filsuch/NE555/Images/IMG_20250101_210914.jpg

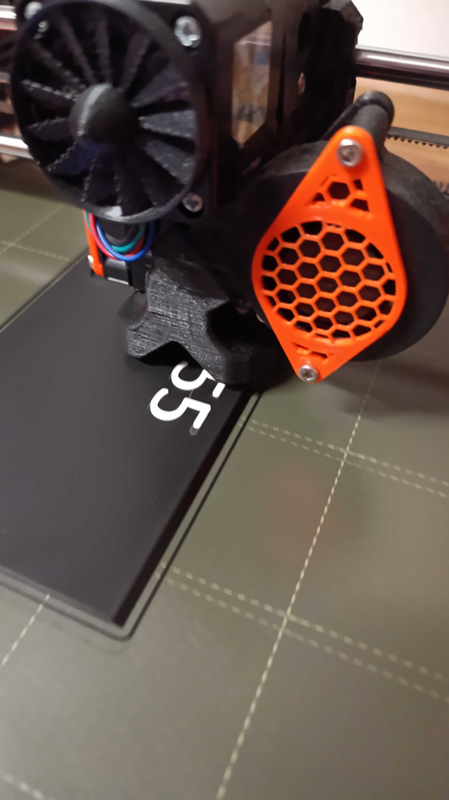
Images/IMG_20250101_210914.jpg
