filsuch/NE555/Images/IMG_20241227_170948.jpg

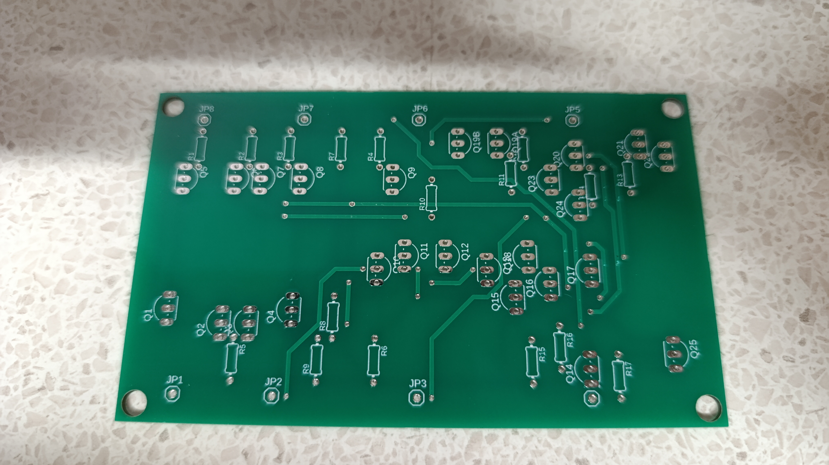
Images/IMG_20241227_170948.jpg
