filsuch/NE555/README.md

# NE555
 školní ročníková práce tvorba NE555
