filsuch/NE555/Images/DPS_bottom.png

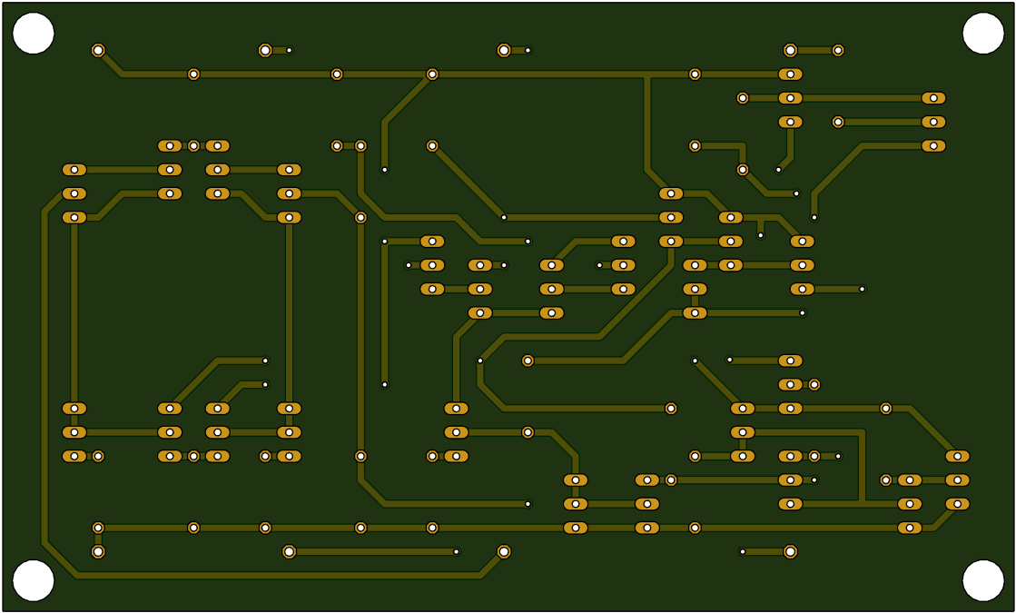
Images/DPS_bottom.png
