filsuch/NE555/Images/DPS_NE555_v2.png

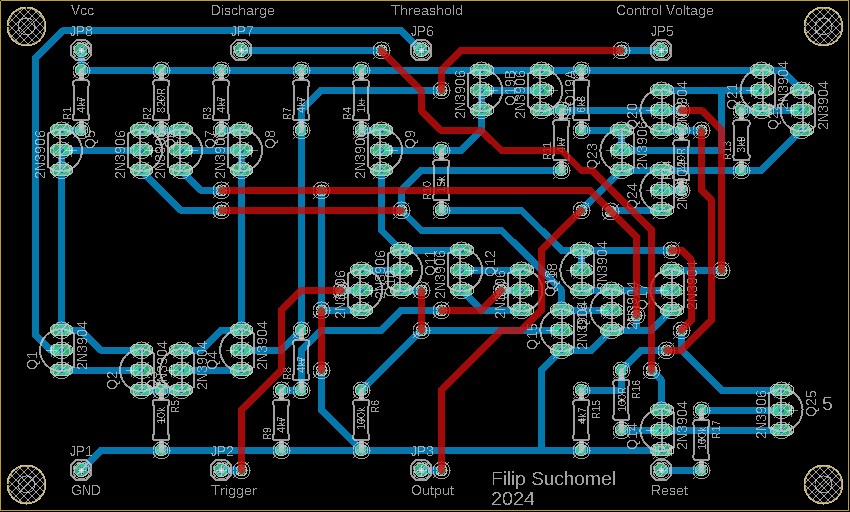
Images/DPS_NE555_v2.png
