filsuch/NE555/Images/Fusion 3d model.png

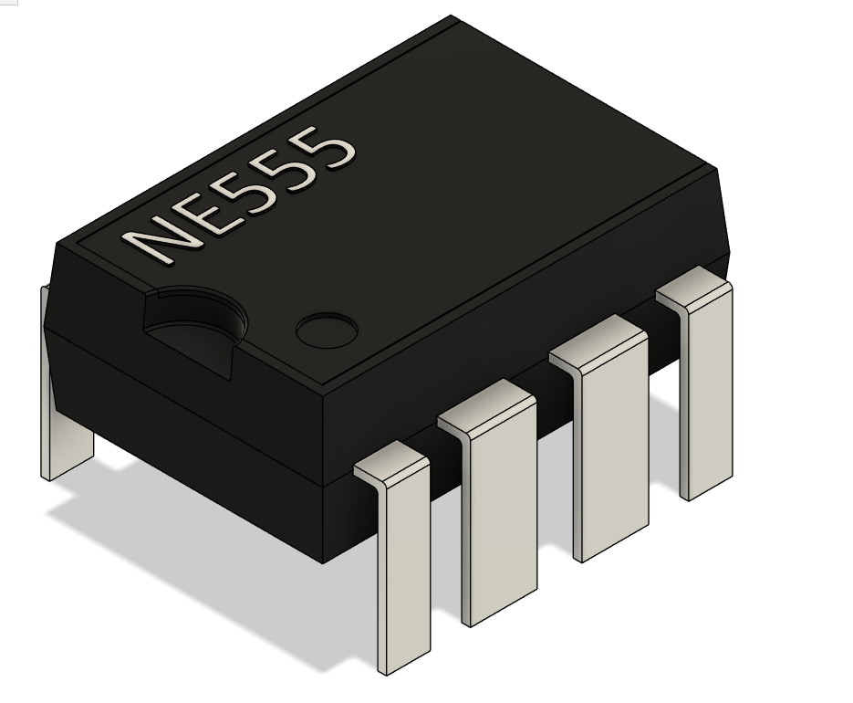
Images/Fusion 3d model.png
