filsuch/NE555/Images/Fusion 3d model_3.png

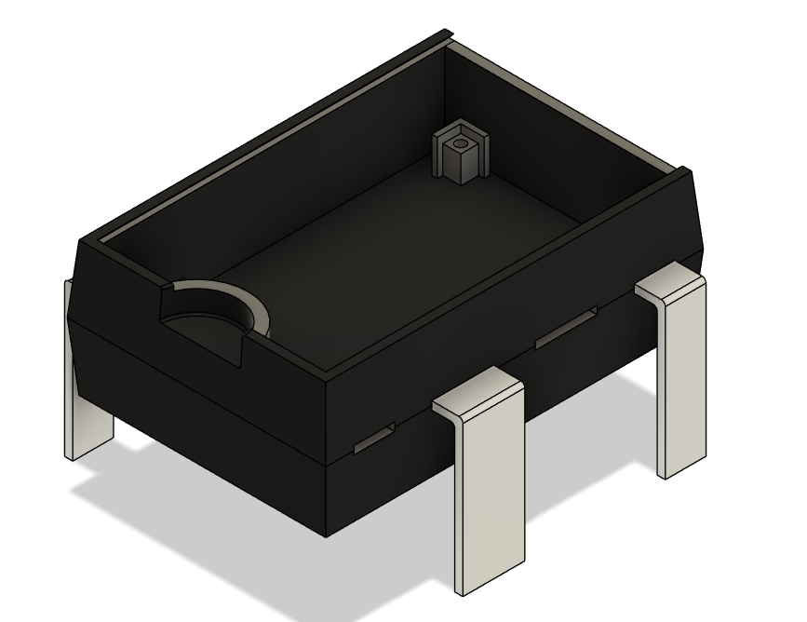
Images/Fusion 3d model_3.png
