filsuch/NE555/Images/IMG_20241227_170939.jpg

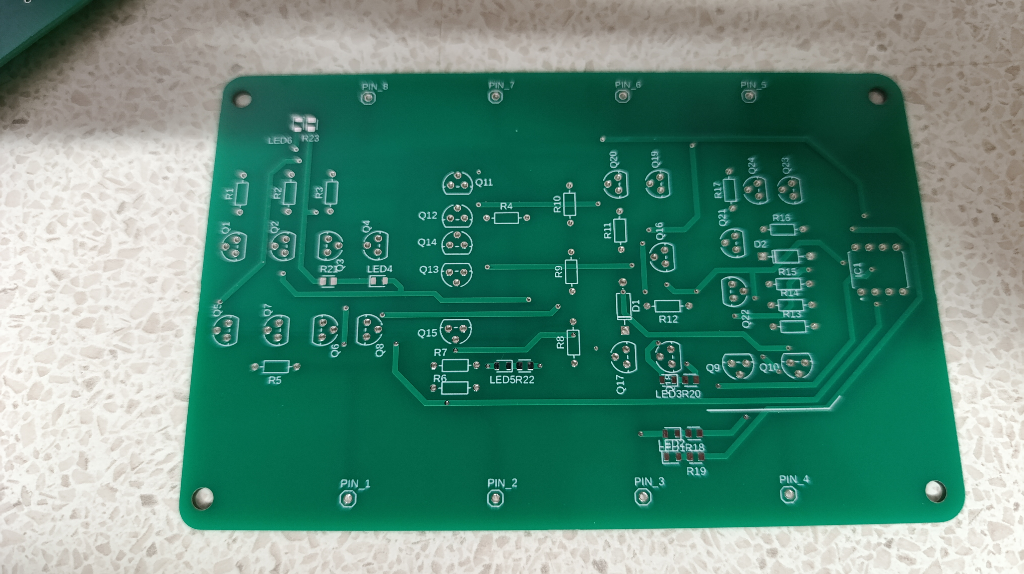
Images/IMG_20241227_170939.jpg
