filsuch/NE555/Images/IMG_20241227_203101.jpg

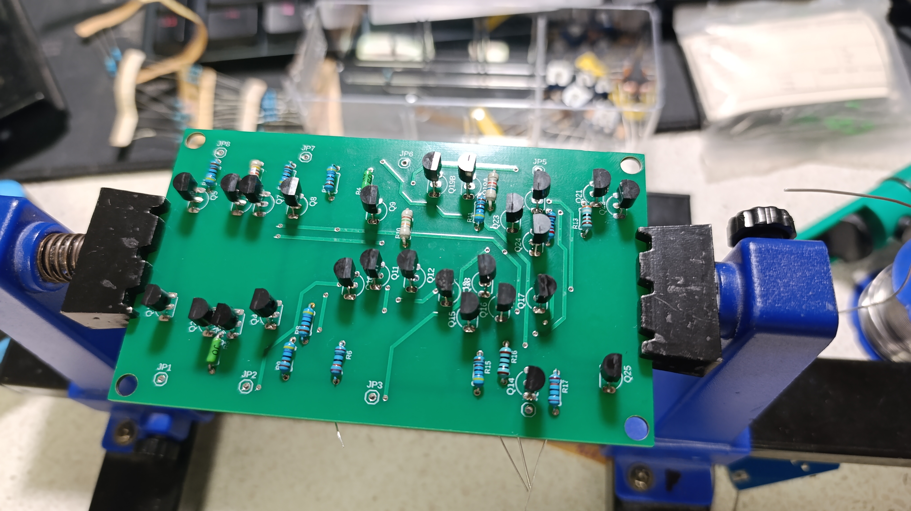
Images/IMG_20241227_203101.jpg
