filsuch/NE555/Images/IMG_20241227_203131.jpg

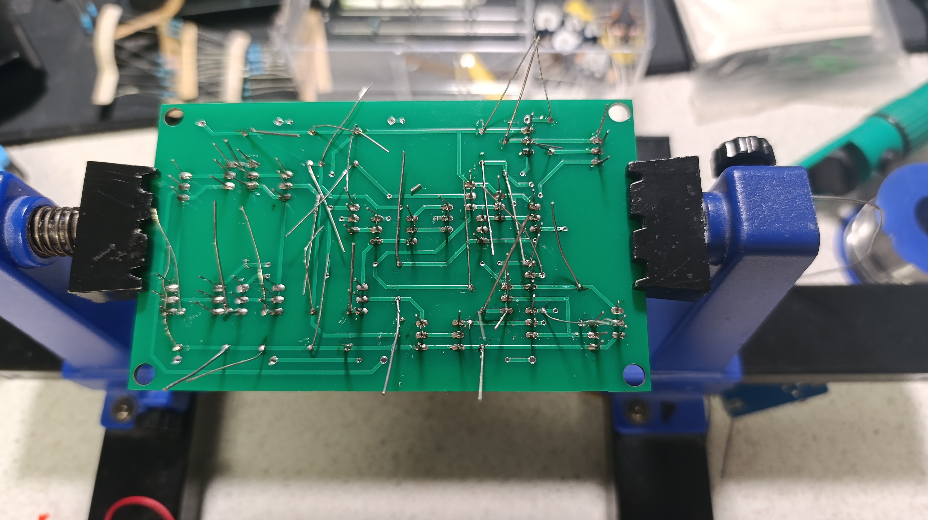
Images/IMG_20241227_203131.jpg
