filsuch/NE555/Images/IMG_20250101_210907.jpg

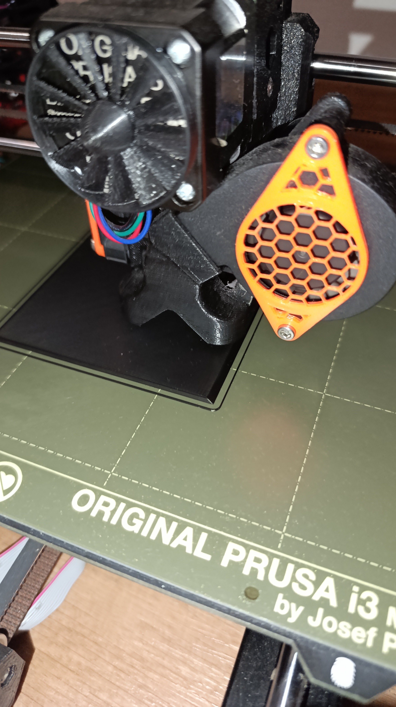
Images/IMG_20250101_210907.jpg
