filsuch/NE555/Images/IMG_20250101_211127.jpg

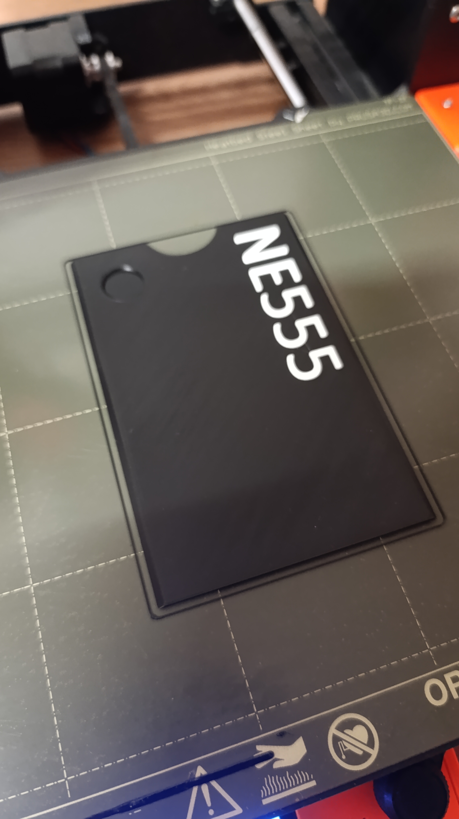
Images/IMG_20250101_211127.jpg
