filsuch/NE555/Images/IMG_20250106_122443.jpg

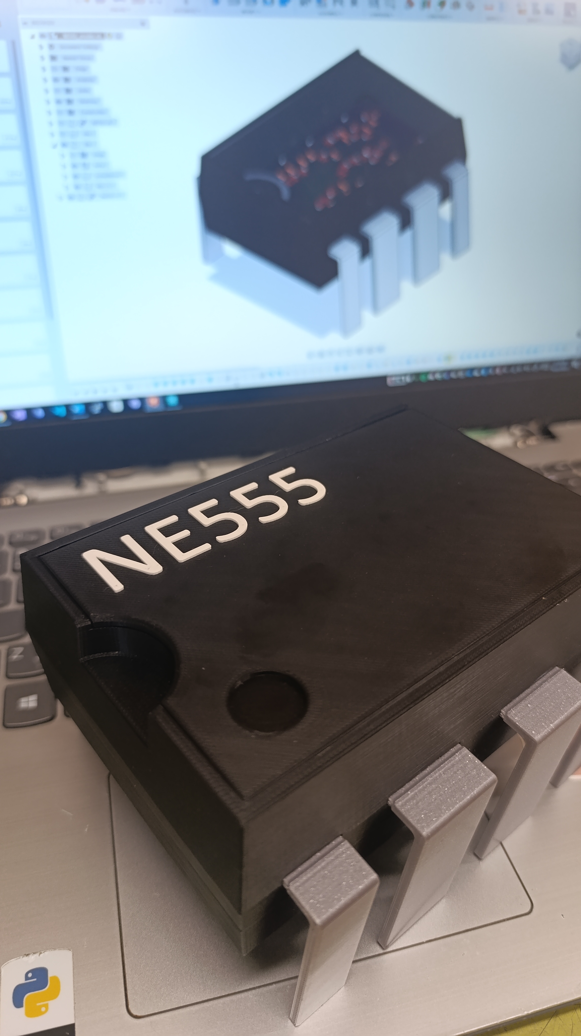
Images/IMG_20250106_122443.jpg
