filsuch/NE555/Images/IMG_20250106_122449.jpg

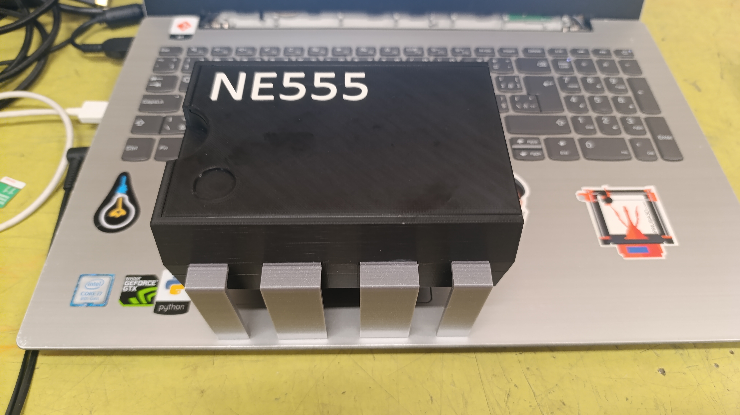
Images/IMG_20250106_122449.jpg
