filsuch/NE555/Images/IMG_20250106_122453.jpg

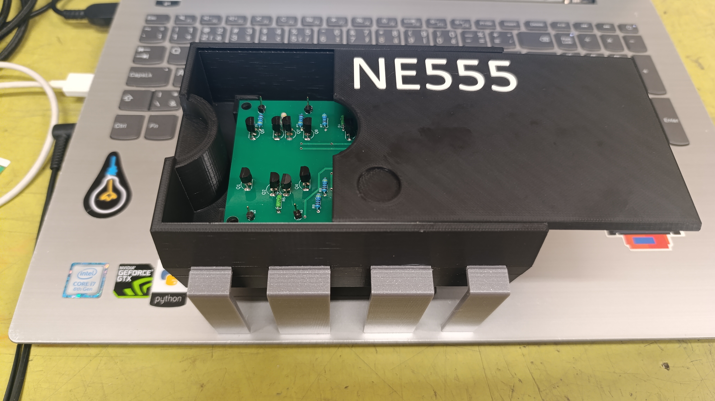
Images/IMG_20250106_122453.jpg
