filsuch/NE555/Images/IMG_20250106_122459.jpg

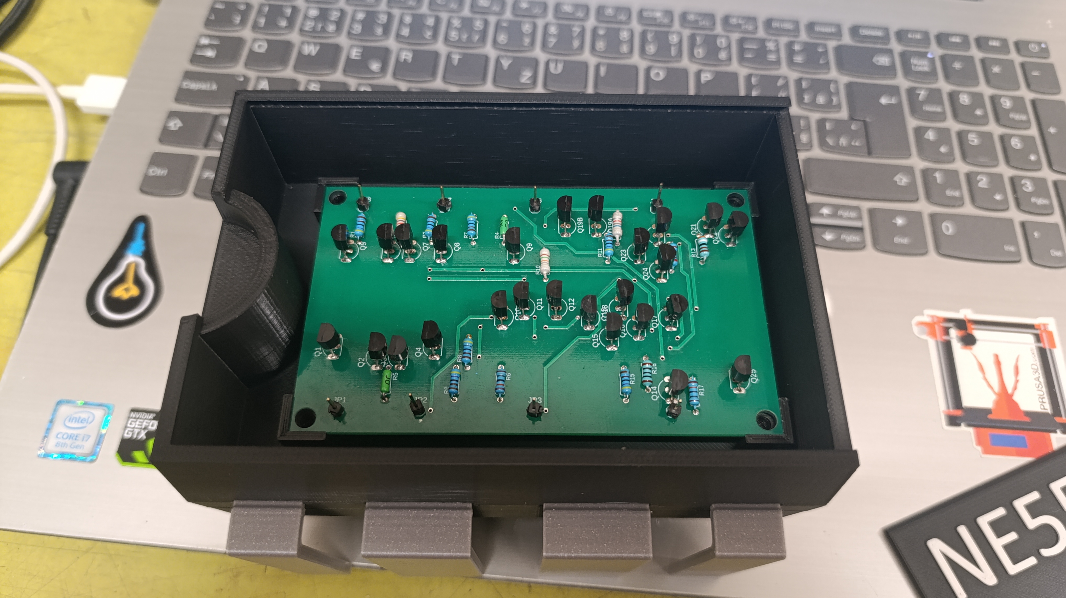
Images/IMG_20250106_122459.jpg
