filsuch/NE555/Images/IMG_20250107_110649.jpg

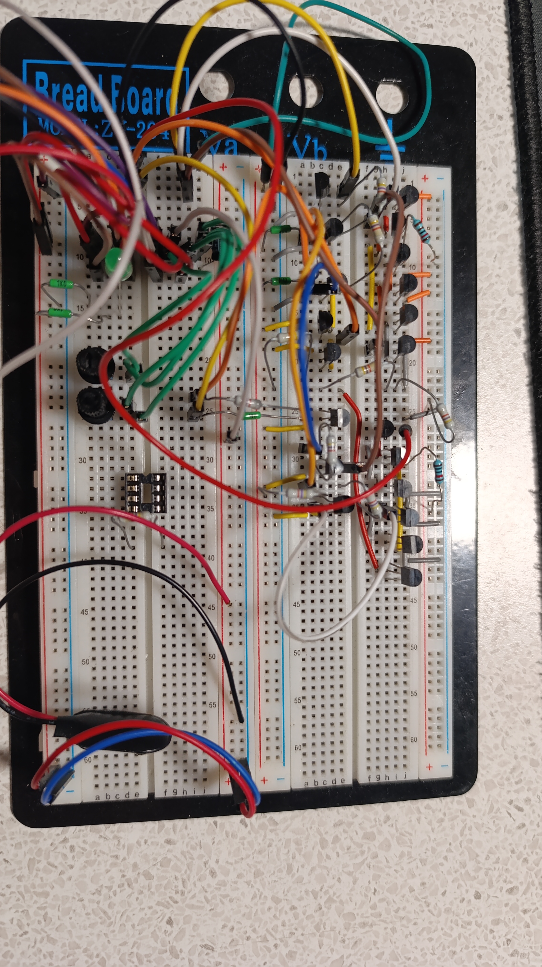
Images/IMG_20250107_110649.jpg
