filsuch/NE555/Images/IMG_20250107_110954.jpg

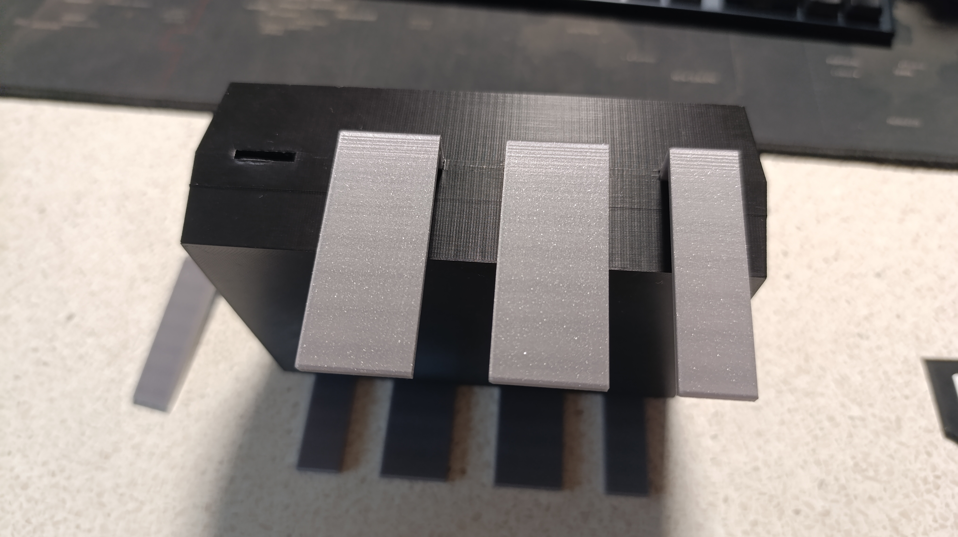
Images/IMG_20250107_110954.jpg
