filsuch/NE555/Images/IMG_20250107_111021.jpg

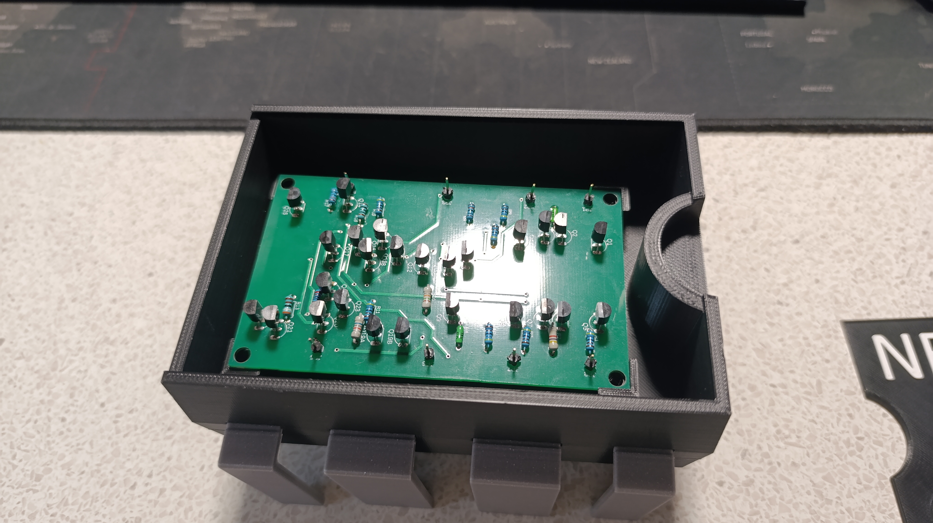
Images/IMG_20250107_111021.jpg
