filsuch/NE555/Images/IMG_20250107_111030.jpg

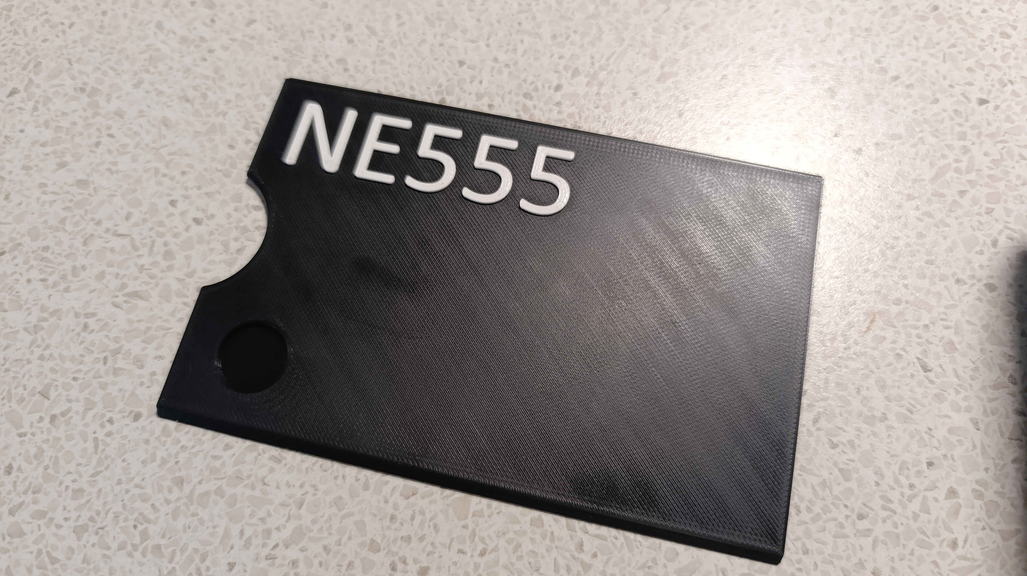
Images/IMG_20250107_111030.jpg
