filsuch/NE555/Images/IMG_20250107_111046.jpg

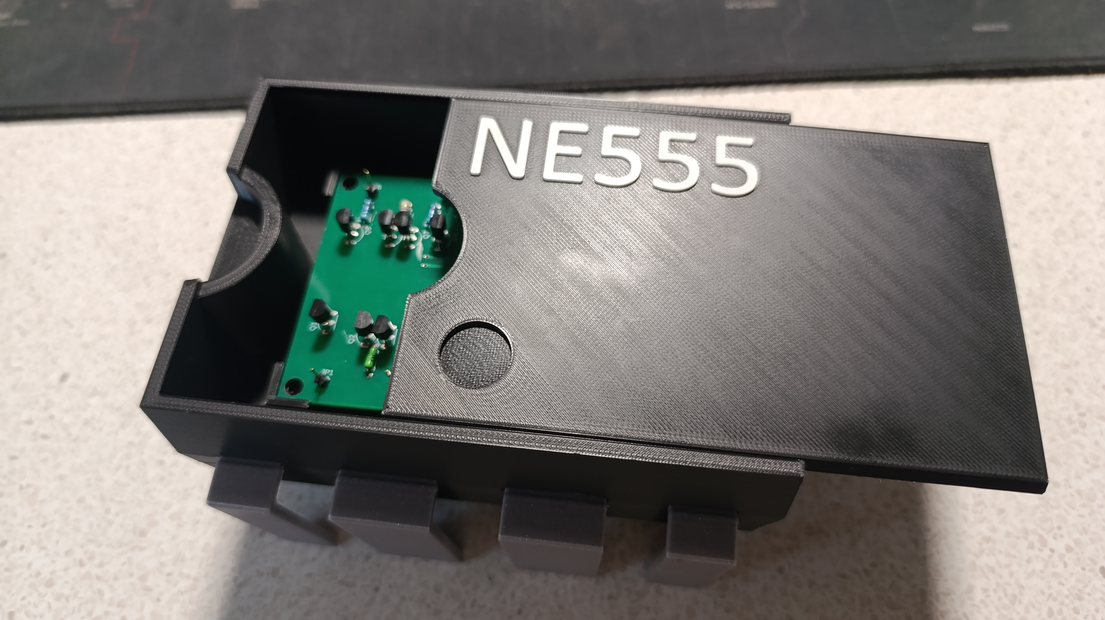
Images/IMG_20250107_111046.jpg
