filsuch/NE555/3D/Slicer/víko.3mf

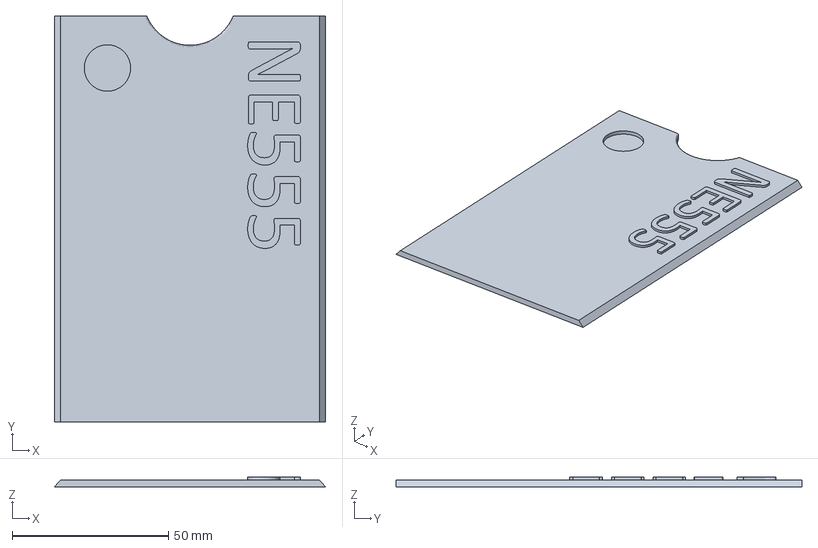
[picture p38: CAD file, 2025-01-01]
3D/Slicer/víko.3mf
86.6 x 129.7 x 3.08 mm
