filsuch/NE555/3D/STL/noha.stl

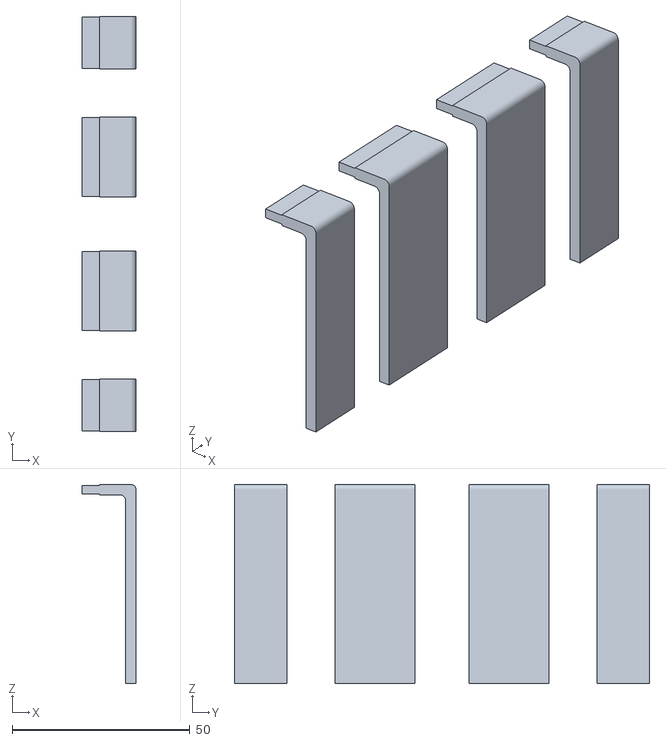
[picture p39: CAD file, 2025-01-10]
3D/STL/noha.stl
15.3 x 116.7 x 56.0
