filsuch/NE555/3D/Slicer/tělo.3mf

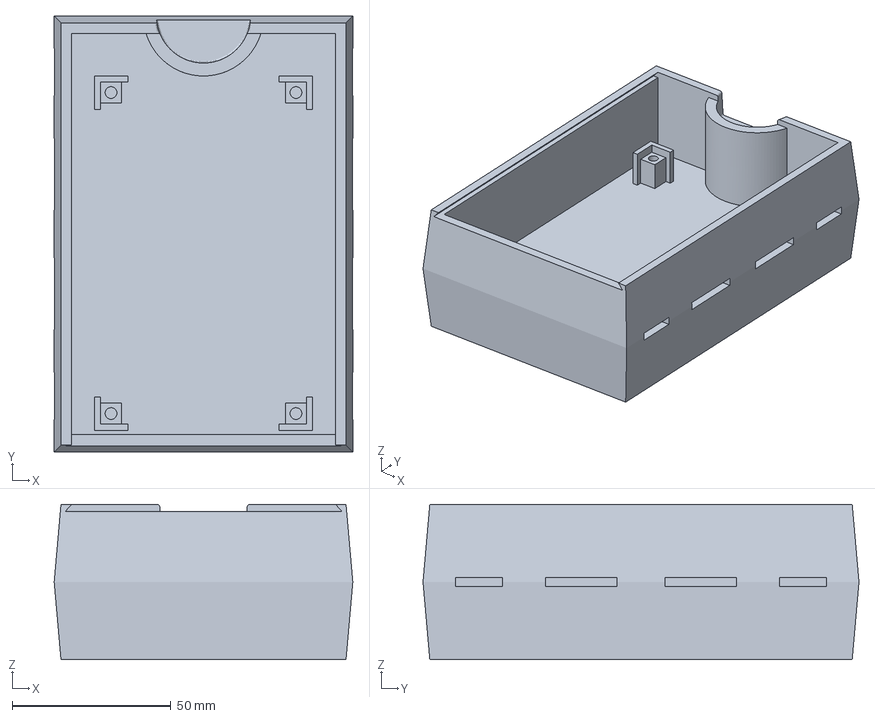
[picture p40: CAD file, 2025-01-01]
3D/Slicer/tělo.3mf
94.0 x 137.3 x 48.9 mm
