filsuch/NE555/3D/Slicer/noha.3mf

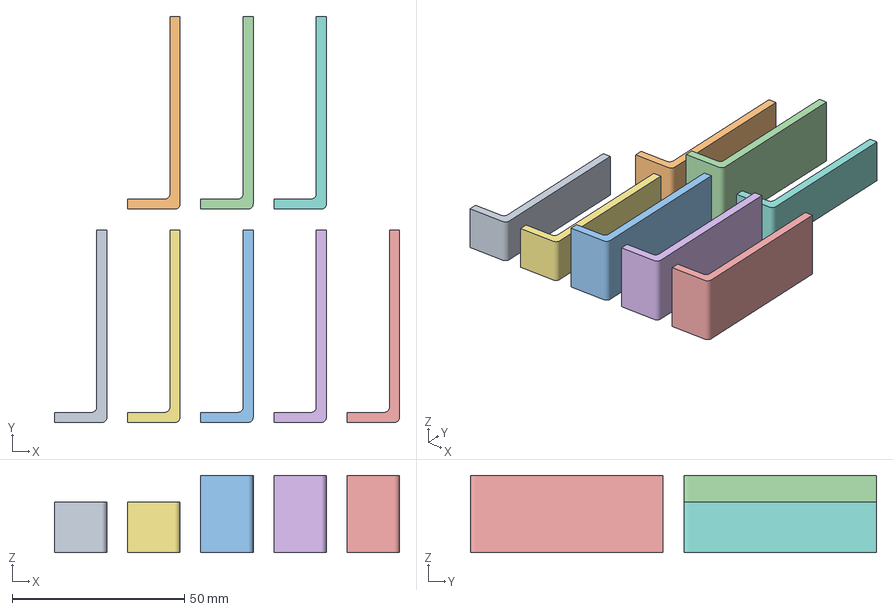
[picture p41: CAD file, 2025-01-01]
3D/Slicer/noha.3mf
100.3 x 118.0 x 22.5 mm
noha.stl_1
noha.stl_1_2
noha.stl_1_3
noha.stl_1_4
