filsuch/NE555/(list of files, cad)

Other CAD files:
3D/STL/tělo.stl
3D/STL/víko.stl
